garyservin/andino/andino_description/meshes/roundbot/caster.stl

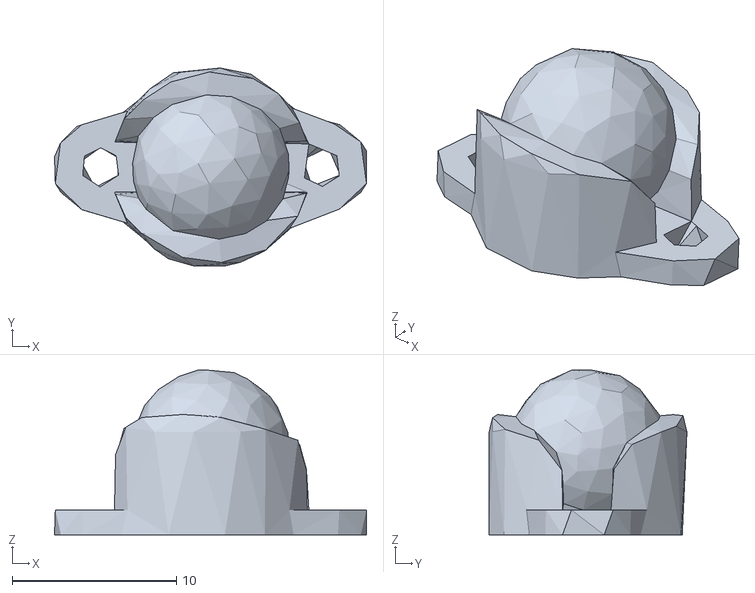
[picture p12: CAD file, 2024-04-09]
andino_description/meshes/roundbot/caster.stl
19.0 x 12.1 x 10.1
