garyservin/andino/andino_description/meshes/sensors/ld19.stl

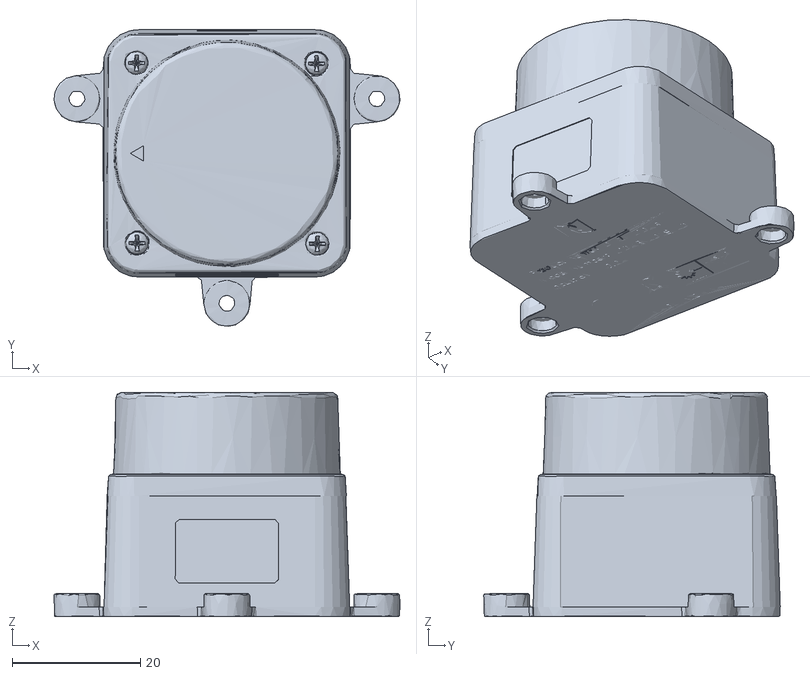
[picture p13: CAD file, 2024-04-09]
andino_description/meshes/sensors/ld19.stl
54.0 x 46.3 x 35.0
