garyservin/andino/andino_description/meshes/roundbot/pololu-wheel-80x10mm-black.stl

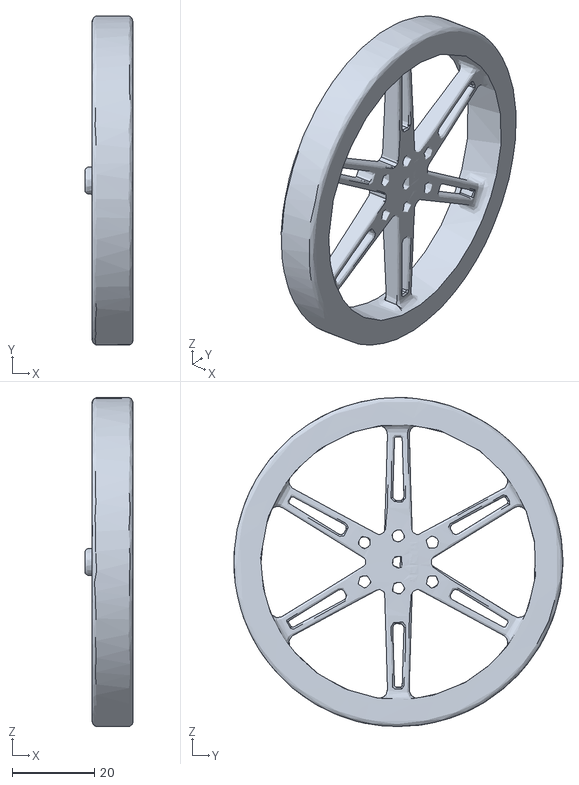
[picture p14: CAD file, 2024-04-09]
andino_description/meshes/roundbot/pololu-wheel-80x10mm-black.stl
11.8 x 80.0 x 80.0
