garyservin/andino/andino_bringup/CHANGELOG.rst

^^^^^^^^^^^^^^^^^^^^^^^^^^^^^^^^^^^^
Changelog for package andino_bringup
^^^^^^^^^^^^^^^^^^^^^^^^^^^^^^^^^^^^

0.2.0 (2024-07-19)
------------------
* Camera info yaml (`#231 <https://github.com/Ekumen-OS/andino/issues/231>`_)
* Added README for andino_bringup (`#233 <https://github.com/Ekumen-OS/andino/issues/233>`_)
* Matches convention with cmd_vel and odom topics. (`#223 <https://github.com/Ekumen-OS/andino/issues/223>`_)
* Add missing dependency for keyboard teleop launchfile (`#227 <https://github.com/Ekumen-OS/andino/issues/227>`_)
* Contributors: Franco Cipollone, Gary Servin, Jesús Silva

0.1.0 (2023-10-09)
------------------
* Fixes rosbag2 dependency. (`#151 <https://github.com/Ekumen-OS/andino/issues/151>`_)
* Adds convenient launch file for recording a rosbag (`#147 <https://github.com/Ekumen-OS/andino/issues/147>`_)
* Fixes USB port names (`#143 <https://github.com/Ekumen-OS/andino/issues/143>`_)
* Adds a laser range filter for the laser scan messages. (`#144 <https://github.com/Ekumen-OS/andino/issues/144>`_)
* Provides info about joy teleoperation. (`#142 <https://github.com/Ekumen-OS/andino/issues/142>`_)
* Modify name of missing reference. (`#71 <https://github.com/Ekumen-OS/andino/issues/71>`_)
* Contributors: Franco Cipollone
