garyservin/andino/andino_description/CHANGELOG.rst

^^^^^^^^^^^^^^^^^^^^^^^^^^^^^^^^^^^^^^^^
Changelog for package andino_description
^^^^^^^^^^^^^^^^^^^^^^^^^^^^^^^^^^^^^^^^

0.2.0 (2024-07-19)
------------------
* Allow custom configuration (`#243 <https://github.com/Ekumen-OS/andino/issues/243>`_)
* Process xacro file test (`#244 <https://github.com/Ekumen-OS/andino/issues/244>`_)
* Contributors: Jesús Silva

0.1.0 (2023-10-09)
------------------
* Updated lidar mesh (`#165 <https://github.com/Ekumen-OS/andino/issues/165>`_)
* Fixes USB port names (`#143 <https://github.com/Ekumen-OS/andino/issues/143>`_)
* Add new mesh for second base (`#141 <https://github.com/Ekumen-OS/andino/issues/141>`_)
* Parametrizes config yaml path in andino.urdf.xacro (`#137 <https://github.com/Ekumen-OS/andino/issues/137>`_)
* Adds materials to gazebo sim (`#112 <https://github.com/Ekumen-OS/andino/issues/112>`_)
* Caster wheel and ros_control in gazebo (`#105 <https://github.com/Ekumen-OS/andino/issues/105>`_)
* Add optional parameter to generate Fixed/Coninuous caster joint (`#100 <https://github.com/Ekumen-OS/andino/issues/100>`_)
* Fix wrong if/unless wheel xacro (`#95 <https://github.com/Ekumen-OS/andino/issues/95>`_)
* Gazebo Classic Simulation humble (`#78 <https://github.com/Ekumen-OS/andino/issues/78>`_)
* Fixes xacro file starting with a comment. (`#91 <https://github.com/Ekumen-OS/andino/issues/91>`_)
* Removes gazebo references from andino_description. (`#83 <https://github.com/Ekumen-OS/andino/issues/83>`_)
* Adds camera mount mesh and adjusts sizes. (`#81 <https://github.com/Ekumen-OS/andino/issues/81>`_)
* Contributors: Christian Barcelo, Franco Cipollone, Ignacio Davila, Leo Neumarkt, Olmer Garcia-Bedoya
