garyservin/andino/andino_firmware/CHANGELOG.rst

^^^^^^^^^^^^^^^^^^^^^^^^^^^^^^^^^^^^^
Changelog for package andino_firmware
^^^^^^^^^^^^^^^^^^^^^^^^^^^^^^^^^^^^^

0.2.0 (2024-07-19)
------------------
* Camera info yaml (`#231 <https://github.com/Ekumen-OS/andino/issues/231>`_)
* Improve Shell unit tests (`#245 <https://github.com/Ekumen-OS/andino/issues/245>`_)
* fix minor typo in App class (`#246 <https://github.com/Ekumen-OS/andino/issues/246>`_)
* Changes to add IMU to andino firmware (`#215 <https://github.com/Ekumen-OS/andino/issues/215>`_)
* Add Shell class tests (`#242 <https://github.com/Ekumen-OS/andino/issues/242>`_)
* Modify Shell class API to allow dependency injection (`#221 <https://github.com/Ekumen-OS/andino/issues/221>`_)
* Add basic Platform IO instructions (`#229 <https://github.com/Ekumen-OS/andino/issues/229>`_)
* Add serial stream interface and the Arduino implementation (`#220 <https://github.com/Ekumen-OS/andino/issues/220>`_)
* Rename PID class (`#218 <https://github.com/Ekumen-OS/andino/issues/218>`_)
* Rename init method from Shell class (`#219 <https://github.com/Ekumen-OS/andino/issues/219>`_)
* Add PID class tests (`#217 <https://github.com/Ekumen-OS/andino/issues/217>`_)
* Only send motor commands if pid is enabled (`#222 <https://github.com/Ekumen-OS/andino/issues/222>`_)
* Add Encoder unit tests (`#214 <https://github.com/Ekumen-OS/andino/issues/214>`_)
* Add Motor unit tests (`#211 <https://github.com/Ekumen-OS/andino/issues/211>`_)
* Modify Encoder class API to allow dependency injection (`#213 <https://github.com/Ekumen-OS/andino/issues/213>`_)
* Modify Motor class API to allow dependency injection (`#210 <https://github.com/Ekumen-OS/andino/issues/210>`_)
* Add digital in interface (`#212 <https://github.com/Ekumen-OS/andino/issues/212>`_)
* Add PWM output interface and the Arduino implementation (`#209 <https://github.com/Ekumen-OS/andino/issues/209>`_)
* Add digital output interface and the Arduino implementation (`#208 <https://github.com/Ekumen-OS/andino/issues/208>`_)
* Fix Arduino header file inclusion (`#207 <https://github.com/Ekumen-OS/andino/issues/207>`_)
* Add basic setup for unit testing (`#205 <https://github.com/Ekumen-OS/andino/issues/205>`_)
* Improve app loop (`#197 <https://github.com/Ekumen-OS/andino/issues/197>`_)
* Improve command prompt parsing (`#194 <https://github.com/Ekumen-OS/andino/issues/194>`_)
* Add Shell class (`#193 <https://github.com/Ekumen-OS/andino/issues/193>`_)
* Supports Arduino Nano by providing a new Arduino configuration. (`#195 <https://github.com/Ekumen-OS/andino/issues/195>`_)
* Fixes some compilation warnings. (`#196 <https://github.com/Ekumen-OS/andino/issues/196>`_)
* Add command methods (`#187 <https://github.com/Ekumen-OS/andino/issues/187>`_)
* Enable all compiler warnings (`#186 <https://github.com/Ekumen-OS/andino/issues/186>`_)
* Add Hw struct (`#177 <https://github.com/Ekumen-OS/andino/issues/177>`_)
* Add Constants struct (`#176 <https://github.com/Ekumen-OS/andino/issues/176>`_)
* Add App class (`#175 <https://github.com/Ekumen-OS/andino/issues/175>`_)
* Add main function (`#173 <https://github.com/Ekumen-OS/andino/issues/173>`_)
* Fixes link to commands. (`#178 <https://github.com/Ekumen-OS/andino/issues/178>`_)
* Add Encoder class (`#172 <https://github.com/Ekumen-OS/andino/issues/172>`_)
* Contributors: Agustin Alba Chicar, Franco Cipollone, Gary Servin, Gonzo, Javier Balloffet, Jesús Silva

0.1.0 (2023-10-09)
------------------
* Don't send stop constantly (`#150 <https://github.com/Ekumen-OS/andino/issues/150>`_)
* Make sure to initialize motor speeds (`#149 <https://github.com/Ekumen-OS/andino/issues/149>`_)
* Adds package structures to firmware and hardware. (`#133 <https://github.com/Ekumen-OS/andino/issues/133>`_)
* Add PCInt class (`#131 <https://github.com/Ekumen-OS/andino/issues/131>`_)
* Improve PID class (`#128 <https://github.com/Ekumen-OS/andino/issues/128>`_)
* Add PID class (`#125 <https://github.com/Ekumen-OS/andino/issues/125>`_)
* Refactor PID module (`#124 <https://github.com/Ekumen-OS/andino/issues/124>`_)
* Replace include guard in hw.h with pragma directive (`#126 <https://github.com/Ekumen-OS/andino/issues/126>`_)
* Remove blank line (`#127 <https://github.com/Ekumen-OS/andino/issues/127>`_)
* Add Motor class (`#108 <https://github.com/Ekumen-OS/andino/issues/108>`_)
* Move pin definitions to hw.h header file (`#107 <https://github.com/Ekumen-OS/andino/issues/107>`_)
* Add ClangFormat config file (`#106 <https://github.com/Ekumen-OS/andino/issues/106>`_)
* Add PlatformIO support (`#86 <https://github.com/Ekumen-OS/andino/issues/86>`_)
* Contributors: Franco Cipollone, Gary Servin, Javier Balloffet
