garyservin/andino/andino_hardware/CHANGELOG.rst

^^^^^^^^^^^^^^^^^^^^^^^^^^^^^^^^^^^^^
Changelog for package andino_hardware
^^^^^^^^^^^^^^^^^^^^^^^^^^^^^^^^^^^^^

0.2.0 (2024-07-19)
------------------
* Camera info yaml (`#231 <https://github.com/Ekumen-OS/andino/issues/231>`_)
* Update andino_hardware README.md (`#256 <https://github.com/Ekumen-OS/andino/issues/256>`_)
* Update connections diagram (`#252 <https://github.com/Ekumen-OS/andino/issues/252>`_)
* Add new Arduino diagram (`#249 <https://github.com/Ekumen-OS/andino/issues/249>`_)
* Add a note about not updated diagram (`#248 <https://github.com/Ekumen-OS/andino/issues/248>`_)
* Update bill of materials (`#241 <https://github.com/Ekumen-OS/andino/issues/241>`_)
* Adds some clarifications about the installation process. (`#199 <https://github.com/Ekumen-OS/andino/issues/199>`_)
* Contributors: Agustin Alba Chicar, Franco Cipollone, Jesús Silva

0.1.0 (2023-10-09)
------------------
* Fixes USB port names (`#143 <https://github.com/Ekumen-OS/andino/issues/143>`_)
* Provides info about joy teleoperation. (`#142 <https://github.com/Ekumen-OS/andino/issues/142>`_)
* Adds package structures to firmware and hardware. (`#133 <https://github.com/Ekumen-OS/andino/issues/133>`_)
* Add STL models for the raspi camera mount (`#75 <https://github.com/Ekumen-OS/andino/issues/75>`_)
* Contributors: Franco Cipollone, Leo Neumarkt
