garyservin/andino/andino_base/CHANGELOG.rst

^^^^^^^^^^^^^^^^^^^^^^^^^^^^^^^^^
Changelog for package andino_base
^^^^^^^^^^^^^^^^^^^^^^^^^^^^^^^^^

0.2.0 (2024-07-19)
------------------
* explicitly add <cstdint> header for fixed width integer types (`#254 <https://github.com/Ekumen-OS/andino/issues/254>`_)
* Contributors: Sakura286

0.1.0 (2023-10-09)
------------------
* Adds pkg-config module dependency (`#161 <https://github.com/Ekumen-OS/andino/issues/161>`_)
* Adds explicit linking of serial library to motor_driver_demo app. (`#157 <https://github.com/Ekumen-OS/andino/issues/157>`_)
* Removes CMake dependency to controller_manager (`#156 <https://github.com/Ekumen-OS/andino/issues/156>`_)
* Contributors: Franco Cipollone
