garyservin/andino/andino_control/CHANGELOG.rst

^^^^^^^^^^^^^^^^^^^^^^^^^^^^^^^^^^^^
Changelog for package andino_control
^^^^^^^^^^^^^^^^^^^^^^^^^^^^^^^^^^^^

0.2.0 (2024-07-19)
------------------
* Matches convention with cmd_vel and odom topics. (`#223 <https://github.com/Ekumen-OS/andino/issues/223>`_)
* Contributors: Franco Cipollone

0.1.0 (2023-10-09)
------------------
* Sets up ros control for the andino robot
* Contributors: Franco Cipollone
