garyservin/andino/andino_navigation/CHANGELOG.rst

^^^^^^^^^^^^^^^^^^^^^^^^^^^^^^^^^^^^^^^
Changelog for package andino_navigation
^^^^^^^^^^^^^^^^^^^^^^^^^^^^^^^^^^^^^^^

0.2.0 (2024-07-19)
------------------
* andino_apps package created and andino_navigation package updated (`#235 <https://github.com/Ekumen-OS/andino/issues/235>`_)
* Improves andino_navigation package. (`#224 <https://github.com/Ekumen-OS/andino/issues/224>`_)
* Contributors: Franco Cipollone, Jesús Silva

0.1.0 (2023-10-09)
------------------
* Renames andino_gazebo package to andino_gz_classic. (`#153 <https://github.com/Ekumen-OS/andino/issues/153>`_)
* Updates logo and minor doc changes (`#130 <https://github.com/Ekumen-OS/andino/issues/130>`_)
* nav2 gazebo example (`#109 <https://github.com/Ekumen-OS/andino/issues/109>`_)
* Contributors: Franco Cipollone, Olmer Garcia-Bedoya
