garyservin/andino/andino_slam/CHANGELOG.rst

^^^^^^^^^^^^^^^^^^^^^^^^^^^^^^^^^
Changelog for package andino_slam
^^^^^^^^^^^^^^^^^^^^^^^^^^^^^^^^^

0.2.0 (2024-07-19)
------------------
* Improves andino_navigation package. (`#224 <https://github.com/Ekumen-OS/andino/issues/224>`_)
* Contributors: Franco Cipollone

0.1.0 (2023-10-09)
------------------
* Adds convenient launch file for rviz in andino_slam package. (`#145 <https://github.com/Ekumen-OS/andino/issues/145>`_)
* Updates logo and minor doc changes (`#130 <https://github.com/Ekumen-OS/andino/issues/130>`_)
* Adds andino_slam package. (`#82 <https://github.com/Ekumen-OS/andino/issues/82>`_)
* Contributors: Franco Cipollone
