garyservin/andino/andino_firmware/src/main.cpp

// Code in this file is inspired by:
// https://github.com/hbrobotics/ros_arduino_bridge/blob/indigo-devel/ros_arduino_firmware/src/libraries/ROSArduinoBridge/ROSArduinoBridge.ino
//
// ----------------------------------------------------------------------------
// ros_arduino_bridge's license follows:
//
// Software License Agreement (BSD License)
//
// Copyright (c) 2012, Patrick Goebel.
// All rights reserved.
//
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
//   * Redistributions of source code must retain the above copyright
//     notice, this list of conditions and the following disclaimer.
//   * Redistributions in binary form must reproduce the above
//     copyright notice, this list of conditions and the following
//     disclaimer in the documentation and/or other materials provided
//     with the distribution.
//
// THIS SOFTWARE IS PROVIDED BY THE COPYRIGHT HOLDERS AND CONTRIBUTORS
// "AS IS" AND ANY EXPRESS OR IMPLIED WARRANTIES, INCLUDING, BUT NOT
// LIMITED TO, THE IMPLIED WARRANTIES OF MERCHANTABILITY AND FITNESS
// FOR A PARTICULAR PURPOSE ARE DISCLAIMED. IN NO EVENT SHALL THE
// COPYRIGHT OWNER OR CONTRIBUTORS BE LIABLE FOR ANY DIRECT, INDIRECT,
// INCIDENTAL, SPECIAL, EXEMPLARY, OR CONSEQUENTIAL DAMAGES (INCLUDING,
// BUT NOT LIMITED TO, PROCUREMENT OF SUBSTITUTE GOODS OR SERVICES;
// LOSS OF USE, DATA, OR PROFITS; OR BUSINESS INTERRUPTION) HOWEVER
// CAUSED AND ON ANY THEORY OF LIABILITY, WHETHER IN CONTRACT, STRICT
// LIABILITY, OR TORT (INCLUDING NEGLIGENCE OR OTHERWISE) ARISING IN
// ANY WAY OUT OF THE USE OF THIS SOFTWARE, EVEN IF ADVISED OF THE
// POSSIBILITY OF SUCH DAMAGE.

// BSD 3-Clause License
//
// Copyright (c) 2023, Ekumen Inc.
// All rights reserved.
//
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
// 3. Neither the name of the copyright holder nor the names of its
//    contributors may be used to endorse or promote products derived from
//    this software without specific prior written permission.
//
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
#include "Arduino.h"

#include "web_serial.h"

#include "hw.h"

/* Include definition of serial commands */
#include "commands.h"

/* Motor driver function definitions */
#include "motor.h"

/* Encoder driver function definitions */
#include "encoder_driver.h"

/* PID parameters and functions */
#include "pid.h"

/* Run the PID loop at 30 times per second */
#define PID_RATE 30  // Hz

/* Convert the rate into an interval in milliseconds */
const int PID_INTERVAL = 1000 / PID_RATE;

#define AUTO_STOP_INTERVAL 3000

/* Serial port baud rate */
#define BAUDRATE 115200

/* Maximum PWM signal */
#define MAX_PWM 255

/* Track the next time we make a PID calculation */
unsigned long nextPID = PID_INTERVAL;

/* Stop the robot if it hasn't received a movement command
  in this number of milliseconds */
long lastMotorCommand = AUTO_STOP_INTERVAL;

/* Variable initialization */

// A pair of varibles to help parse serial commands
int arg = 0;
int arg_index = 0;

// Variable to hold an input character
char chr;

// Variable to hold the current single-character command
char cmd;

// Character arrays to hold the first and second arguments
char argv1[16];
char argv2[16];

// The arguments converted to integers
long arg1;
long arg2;

#define HW_SERIAL 0
#define WEB_SERIAL 1

Motor left_motor(LEFT_MOTOR_PWM_GPIO_PIN, LEFT_MOTOR_DIRECTION_GPIO_PIN, true);
Motor right_motor(RIGHT_MOTOR_PWM_GPIO_PIN, RIGHT_MOTOR_DIRECTION_GPIO_PIN);

PID left_pid_controller(30, 10, 0, 10, -MAX_PWM, MAX_PWM);
PID right_pid_controller(30, 10, 0, 10, -MAX_PWM, MAX_PWM);

AiEsp32RotaryEncoder left_encoder(LEFT_ENCODER_A_GPIO_PIN, LEFT_ENCODER_B_GPIO_PIN, ROTARY_ENCODER_STEPS);
AiEsp32RotaryEncoder right_encoder(RIGHT_ENCODER_A_GPIO_PIN, RIGHT_ENCODER_B_GPIO_PIN, ROTARY_ENCODER_STEPS);

// WebSerial Config

AsyncWebServer server(80);

const char* ssid = "";
const char* password = "";


void IRAM_ATTR readLeftEncoderISR()
{
  left_encoder.readEncoder_ISR();
}

void IRAM_ATTR readRightEncoderISR()
{
  right_encoder.readEncoder_ISR();
}

void resetCommand() {
  cmd = 0;
  memset(argv1, 0, sizeof(argv1));
  memset(argv2, 0, sizeof(argv2));
  arg1 = 1;
  arg2 = 0;
  arg = 0;
  arg_index = 0;
}

void runCommand(char src=HW_SERIAL) {
  int i = 0;
  char* p = argv1;
  char* str;
  int pid_args[4];
  arg1 = atoi(argv1);
  arg2 = atoi(argv2);

  switch (cmd) {
    case GET_BAUDRATE:
      if (src == HW_SERIAL) {
        Serial.println(BAUDRATE);
      } else {
        WebSerial.println(BAUDRATE);
      }
      break;
    case ANALOG_READ:
      if (src == HW_SERIAL) {
        Serial.println(analogRead(arg1));
      } else {
        WebSerial.println(analogRead(arg1));
      }
      break;
    case DIGITAL_READ:
      if (src == HW_SERIAL) {
        Serial.println(digitalRead(arg1));
      } else {
        WebSerial.println(digitalRead(arg1));
      }
      break;
    case ANALOG_WRITE:
      analogWrite(arg1, arg2);
      if (src == HW_SERIAL) {
        Serial.println("OK");
      } else {
        WebSerial.println("OK");
      }
      break;
    case DIGITAL_WRITE:
      if (arg2 == 0)
        digitalWrite(arg1, LOW);
      else if (arg2 == 1)
        digitalWrite(arg1, HIGH);
      if (src == HW_SERIAL) {
        Serial.println("OK");
      } else {
        WebSerial.println("OK");
      }
      break;
    case PIN_MODE:
      if (arg2 == 0)
        pinMode(arg1, INPUT);
      else if (arg2 == 1)
        pinMode(arg1, OUTPUT);
      if (src == HW_SERIAL) {
        Serial.println("OK");
      } else {
        WebSerial.println("OK");
      }
      break;
    case READ_ENCODERS:
      if (src == HW_SERIAL) {
        Serial.print(left_encoder.read());
        Serial.print(" ");
        Serial.println(right_encoder.read());
      } else {
        WebSerial.print(left_encoder.read());
        WebSerial.print(" ");
        WebSerial.println(right_encoder.read());
      }
      break;
    case RESET_ENCODERS:
      left_encoder.reset();
      right_encoder.reset();
      left_pid_controller.reset(left_encoder.read());
      right_pid_controller.reset(right_encoder.read());
      if (src == HW_SERIAL) {
        Serial.println("OK");
      } else {
        WebSerial.println("OK");
      }
      break;
    case MOTOR_SPEEDS:
      /* Reset the auto stop timer */
      lastMotorCommand = millis();
      if (arg1 == 0 && arg2 == 0) {
        left_motor.set_speed(0);
        right_motor.set_speed(0);
        left_pid_controller.reset(left_encoder.read());
        right_pid_controller.reset(right_encoder.read());
        left_pid_controller.disable();
        right_pid_controller.disable();
      } else {
        left_pid_controller.enable();
        right_pid_controller.enable();
      }
      // The target speeds are in ticks per second, so we need to convert them
      // to ticks per PID_INTERVAL
      left_pid_controller.set_setpoint(arg1 / PID_RATE);
      right_pid_controller.set_setpoint(arg2 / PID_RATE);
      if (src == HW_SERIAL) {
        Serial.println("OK");
      } else {
        WebSerial.println("OK");
      }
      break;
    case MOTOR_RAW_PWM:
      /* Reset the auto stop timer */
      lastMotorCommand = millis();
      left_pid_controller.reset(left_encoder.read());
      right_pid_controller.reset(right_encoder.read());
      // Sneaky way to temporarily disable the PID
      left_pid_controller.disable();
      right_pid_controller.disable();
      left_motor.set_speed(arg1);
      right_motor.set_speed(arg2);
      if (src == HW_SERIAL) {
        Serial.println("OK");
      } else {
        WebSerial.println("OK");
      }
      break;
    case UPDATE_PID:
      /* Example: "u 30:20:10:50" */
      while ((str = strtok_r(p, ":", &p)) != NULL) {
        pid_args[i] = atoi(str);
        i++;
      }
      left_pid_controller.set_tunings(pid_args[0], pid_args[1], pid_args[2], pid_args[3]);
      right_pid_controller.set_tunings(pid_args[0], pid_args[1], pid_args[2], pid_args[3]);
      Serial.print("PID Updated: ");
      Serial.print(pid_args[0]);
      Serial.print(" ");
      Serial.print(pid_args[1]);
      Serial.print(" ");
      Serial.print(pid_args[2]);
      Serial.print(" ");
      Serial.println(pid_args[3]);
      Serial.println("OK");
      break;
    default:
      if (src == HW_SERIAL) {
        Serial.println("Invalid Command");
      } else {
        WebSerial.println("Invalid Command");
      }
      break;
  }
}

void parseData(char chr, char src=HW_SERIAL){
  // Terminate a command with a CR
  if (chr == 13) {
    if (arg == 1)
      argv1[arg_index] = 0;
    else if (arg == 2)
      argv2[arg_index] = 0;
    runCommand(src);
    resetCommand();
  }
  // Use spaces to delimit parts of the command
  else if (chr == ' ') {
    // Step through the arguments
    if (arg == 0)
      arg = 1;
    else if (arg == 1) {
      argv1[arg_index] = 0;
      arg = 2;
      arg_index = 0;
    }
    //continue;
  } else {
    if (arg == 0) {
      // The first arg is the single-letter command
      cmd = chr;
    } else if (arg == 1) {
      // Subsequent arguments can be more than one character
      argv1[arg_index] = chr;
      arg_index++;
    } else if (arg == 2) {
      argv2[arg_index] = chr;
      arg_index++;
    }
  }
}

/* Message callback of WebSerial */
void recvMsg(uint8_t *data, size_t len){
  for(int i=0; i < len; i++){
    parseData(data[i], WEB_SERIAL);
  }
  parseData(13, WEB_SERIAL);
}

void configure_wifi(){
  WiFi.mode(WIFI_STA);
  WiFi.begin(ssid, password);
  if (WiFi.waitForConnectResult() != WL_CONNECTED) {
      Serial.printf("WiFi Failed!\n");
      return;
  }
  Serial.print("IP Address: ");
  Serial.println(WiFi.localIP());
  // WebSerial is accessible at "<IP Address>/webserial" in browser
  WebSerial.begin(&server);
  /* Attach Message Callback */
  WebSerial.msgCallback(recvMsg);
  server.begin();
}

/* Setup function--runs once at startup. */
void setup() {
  Serial.begin(BAUDRATE);

  // Setup encoders
  left_encoder.begin();
  left_encoder.setup(readLeftEncoderISR);
  left_encoder.setBoundaries(-MAX_VALUE_ENCODERS, MAX_VALUE_ENCODERS, false);
  left_encoder.disableAcceleration();

  right_encoder.begin();
  right_encoder.setup(readRightEncoderISR);
  right_encoder.setBoundaries(-MAX_VALUE_ENCODERS, MAX_VALUE_ENCODERS, false);
  right_encoder.disableAcceleration();

  left_pid_controller.reset(left_encoder.read());
  right_pid_controller.reset(right_encoder.read());

  configure_wifi();
}

/* Main loop.  Read and parse input from the serial port
   and run any valid commands. Run a PID calculation at the target
   interval and check for auto-stop conditions.
*/
void loop() {
  while (Serial.available() > 0) {
    // Read the next character
    chr = Serial.read();
    parseData(chr, HW_SERIAL);
  }

  // Run a PID calculation at the appropriate intervals
  if (millis() > nextPID) {
    int left_motor_speed = 0;
    int right_motor_speed = 0;
    left_pid_controller.compute(left_encoder.read(), left_motor_speed);
    right_pid_controller.compute(right_encoder.read(), right_motor_speed);
    if (left_pid_controller.enabled()){
      left_motor.set_speed(left_motor_speed);
    }
    if (right_pid_controller.enabled()){
      right_motor.set_speed(right_motor_speed);
    }
    nextPID += PID_INTERVAL;
  }

  // Check to see if we have exceeded the auto-stop interval
  if ((millis() - lastMotorCommand) > AUTO_STOP_INTERVAL) {
    lastMotorCommand = millis();
    left_motor.set_speed(0);
    right_motor.set_speed(0);
    left_pid_controller.disable();
    right_pid_controller.disable();
  }
}
