garyservin/andino/(commit log)

2023-10-28 Only send motor commands if pid is enabled
2024-04-06 Make it work with my robot
    [andino_control.urdf.xacro]
2024-04-09 Add option to select robot to use
    [andino.urdf.xacro]
2024-04-09 Add custom urdf config for my bot
    [andino.urdf.xacro, caster.stl, caster_macro.urdf.xacro, common_macros.urdf.xacro, pololu-wheel-80x10mm-black.stl]
2024-04-09 Change configuration for controller to match robot
    [andino_controllers.yaml]
2024-04-09 Update ticks per revolution
    [andino_control.urdf.xacro]
2024-04-09 Changes to roundbot - Changed laser to LDLidar - Update base - Moved ball casters
    [andino.urdf.xacro, caster_macro.urdf.xacro, common_sensors.urdf.xacro, ld19.stl]
2024-04-10 Update motor driver code to more closely match how it works
2024-04-10 Allow to use separated calibration values for each wheel
    [andino_control.urdf.xacro]
2024-07-17 Remove andino_gz_classic and andino_apps references (#259)
    [andino_gz_classic.xacro, andino_materials.xacro]
2024-09-17 Rebase Jazzy branch (#269)
    * Updates CHANGELOG.
    * 0.2.0
    * Updates README.md
    * Adds reference to andino_rmf repo (#263)
    * Include robot assembly (#267)
    * Added all necessary changes to the README
    * Removed a blank line
    ---------
    * Remove andino_gz_classic and andino_apps references (#259)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
2024-11-26 Remap velocity command topic and add relay node
2024-11-26 Use Stamped message for velocity commands
